rocketman768/ChibiAmp/README.md

# ChibiAmp

A complete 10W amp for the HF bands.

## Copyright and License

Everything in this project is either open-source hardware or open-source
software. Please see the `COPYRIGHT` file for details.
