rocketman768/ChibiAmp/renderings/v1.0-back.png

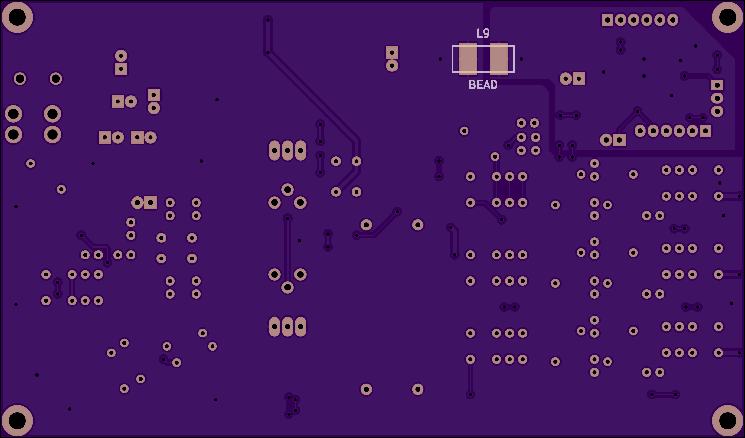
renderings/v1.0-back.png
