rocketman768/ChibiAmp/renderings/v1.0-front.png

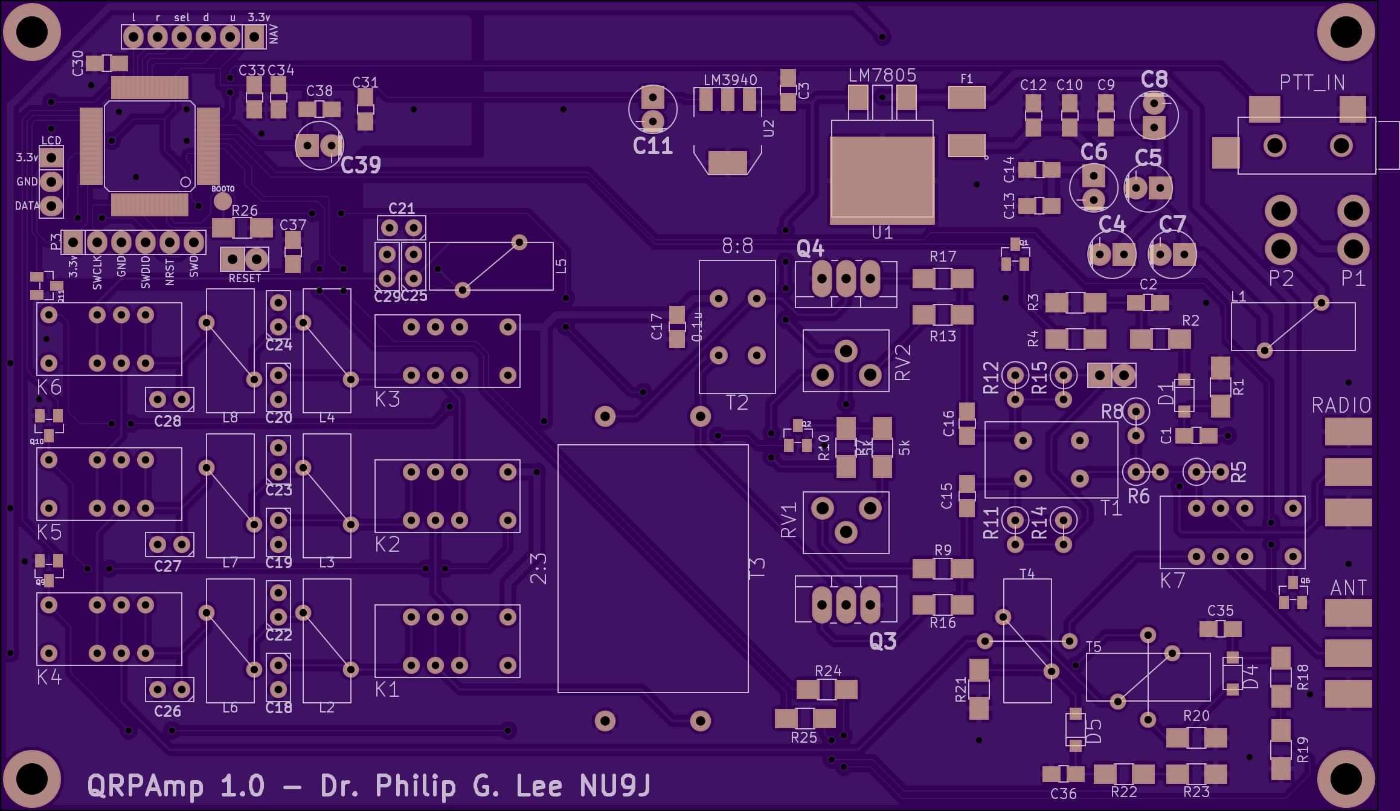
renderings/v1.0-front.png
