rocketman768/ChibiAmp/renderings/v1.1-back.png

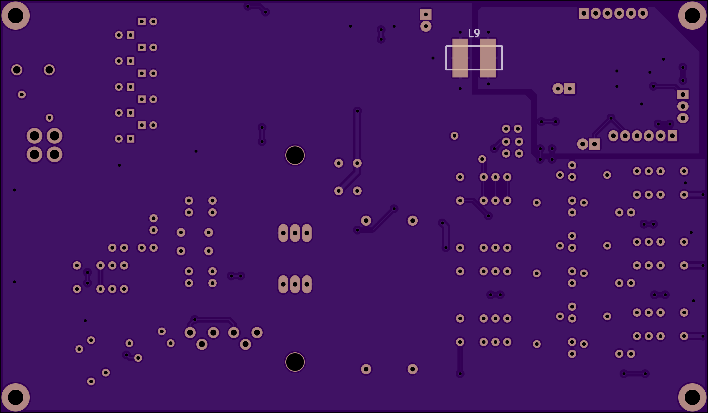
renderings/v1.1-back.png
