rocketman768/ChibiAmp/renderings/v1.1-front.png

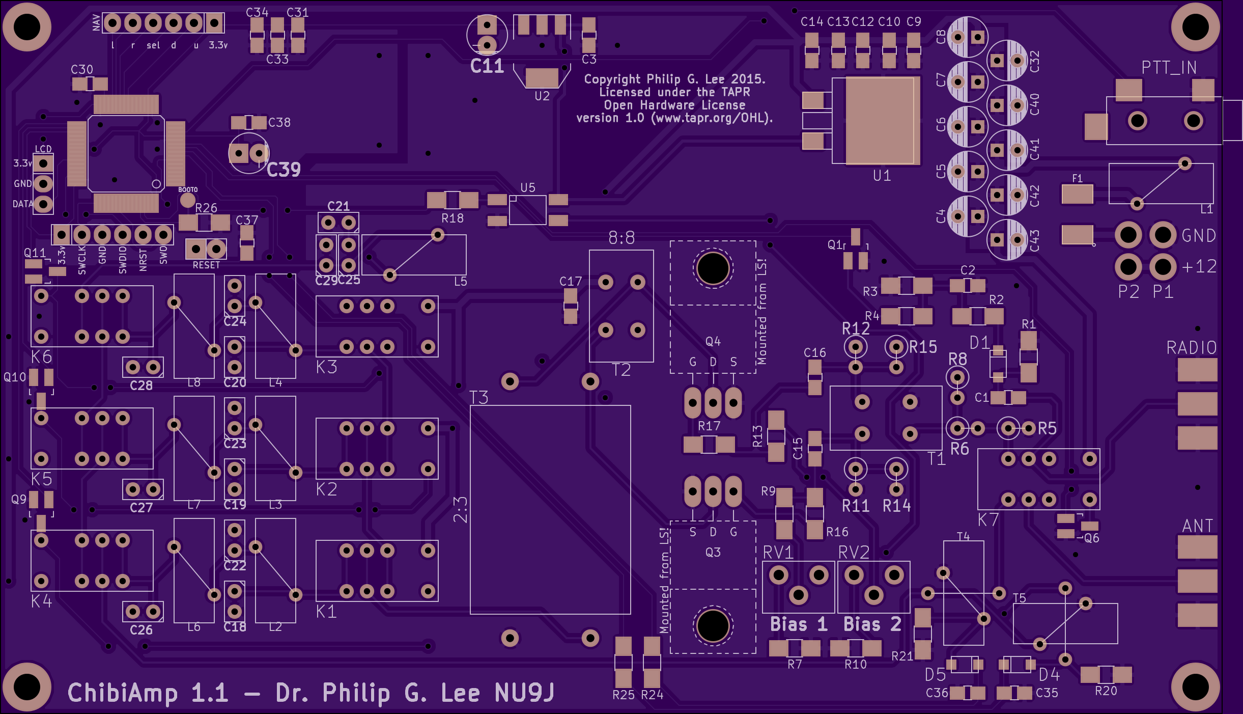
renderings/v1.1-front.png
