rocketman768/ChibiAmp/(threads)

Thread 2 (2015-02-14):

Q1 pads dont match datasheet

rocketman768, 2015-02-14:
Fix by creating EBC symbol and footprint

Closed 2015-03-08.

Thread 6 (2015-03-08):

SWR Measurement Scaling is Wrong

rocketman768, 2015-03-08:
The forward/reflected power scaling is wrong. The way the circuit works, the detected voltage is 1/Nth the real voltage where N is the turns ratio (currently 12). At 20W, the forward line voltage would be 32 V, and the sensed voltage would be 2.6V, well below the 3.3V maximum for the STM32F401.

Next revision should just directly connect to the DC capacitors through the 50k resistors without a voltage divider.

Closed 2015-03-08.

Thread 8 (2015-03-08):

Transistor Placement to Match Heatsink

rocketman768, 2015-03-08:
The transistors should be placed so that the mounting holes line up with the space between the fins.

Closed 2015-07-04.

Thread 10 (2015-03-22):

Resettable fuse trips too early

rocketman768, 2015-03-22:
When the current is 2A, it trips in roughtly 5-10 seconds. At 2A, it should never trip. The designed output power is 10W with about 40% efficiency, i.e. 25W total. This means the total amperage should be 25W / 13.4V = 1.86A. Giving a little headroom, we should expect 2A in normal operation.

PTS18128V200 has a hold current of 2.0A and might be a suitable replacement. However, it has a Vmax of 8V instead of 12V. I think that's OK, since the [spec sheet](http://www.mouser.com/ds/2/87/Bus_Elx_DS_4398_PTS1812_Series-479709.pdf) says this is the maximum voltage at the rated current (100A, which we will definitely never hit).

Closed 2015-07-03.

Thread 9 (2015-03-22):

Gate bias broken

rocketman768, 2015-03-22:
Major issue.

If Q2 has no power applied, then the gate bias to the power MOSFETs is 5V, resulting in about 2A of current. This is enough to trip fuse F1 after 5-10 seconds. This means in the current implementation, Q2 should always be turned on, and power should be flowing.

rocketman768, 2015-03-22:
Might fix this by removing Q2 and placing an optocoupler between +5V and the pots. Mouser part [859-LTV-356T](http://www.mouser.com/ProductDetail/Lite-On/LTV-356T/?qs=sGAEpiMZZMteimceiIVCB4LDcV%252bVgRO4xo2MBcFfZPI%3d) might be suitable.

Closed 2015-07-03.

Thread 11 (2015-12-13):

Extend diode footprints

rocketman768, 2015-12-13:
SD101 footprints are too short

Thread 12 (2015-12-13):

Replace 5k resistors with 4.7k

rocketman768, 2015-12-13:
Maybe some other values with different magnitudes.
