rocketman768/ChibiAmp/qrpamp.kicad_pcb

## KiCad design qrpamp.kicad_pcb (2015-07-06)

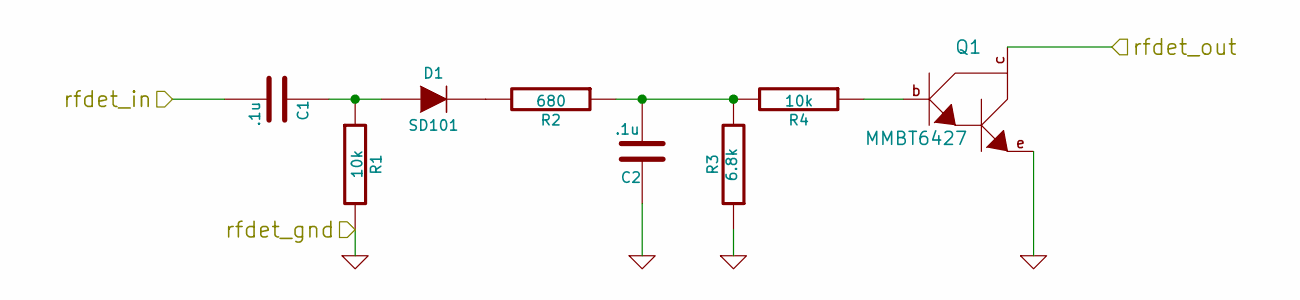
[picture p5: schematic rfdet.sch, ChibiOS 10W HF Amp]

Parts:
C1, C2: .1u; C_0805_HandSoldering
D1: SD101; SOD-123
Q1: MMBT6427; SOT-23-EBC_HandSoldering
R1, R4: 10k; R_1206_HandSoldering
R2: 680; R_1206_HandSoldering
R3: 6.8k; R_1206_HandSoldering

Connections:
/Microcontroller/mcu_rfdet: Q1.c; also elsewhere on the board
/RF In/Out/raw_input: C1.2; also elsewhere on the board
GND: C2.1, Q1.e, R1.2, R3.1; also elsewhere on the board
unnamed: C1.1, D1.1 (A), R1.1
unnamed: C2.2, R2.1, R3.2, R4.2
unnamed: D1.2 (K), R2.2
unnamed: Q1.b, R4.1

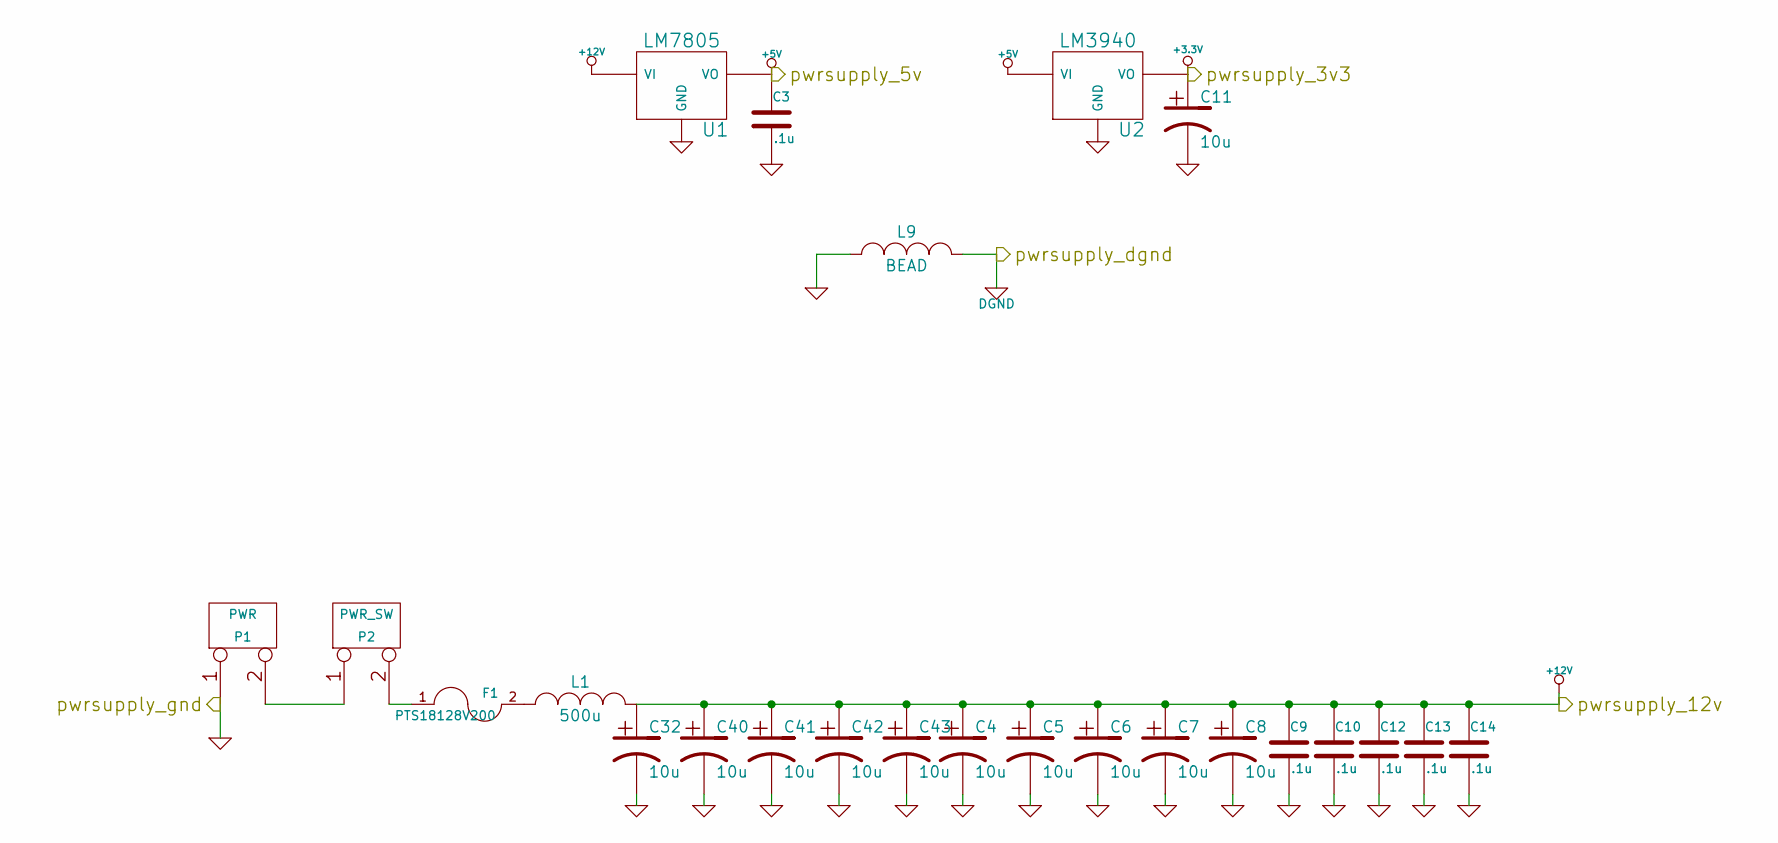
[picture p6: schematic powersupply.sch, ChibiOS 10W HF Amp]

Parts:
C3, C9, C10, C12, C13, C14: .1u; C_0805_HandSoldering
C4, C5, C6, C7, C8, C32, C40, C41, C42, C43: 10u; C_Radial_D5_L11_P2.5
C11: 10u; Capacitor5x11RM2.5
F1: PTS18128V200; SMD-1812_l
L1: 500u; TOROID-50
L9: BEAD; WE-SUCKW
P1: PWR; PWR2-16AWG
P2: PWR_SW; PWR2-16AWG
U1: LM7805; DPAK-3_VIVOGND
U2: LM3940; SOT-223

Connections:
+3.3V: C11.1, U2.VO; also elsewhere on the board
+5V: C3.1, U1.VO, U2.VI; also elsewhere on the board
+12V: C4.1, C5.1, C6.1, C7.1, C8.1, C9.1, C10.1, C12.1, C13.1, C14.1, C32.1, C40.1, C41.1, C42.1, C43.1, L1.2, U1.VI; also elsewhere on the board
DGND: L9.2; also elsewhere on the board
GND: C3.2, C4.2, C5.2, C6.2, C7.2, C8.2, C9.2, C10.2, C11.2, C12.2, C13.2, C14.2, C32.2, C40.2, C41.2, C42.2, C43.2, L9.1, P1.1, U1.GND, U2.GND; also elsewhere on the board
unnamed: F1.1, P2.2 (PM)
unnamed: F1.2, L1.1
unnamed: P1.2 (PM), P2.1

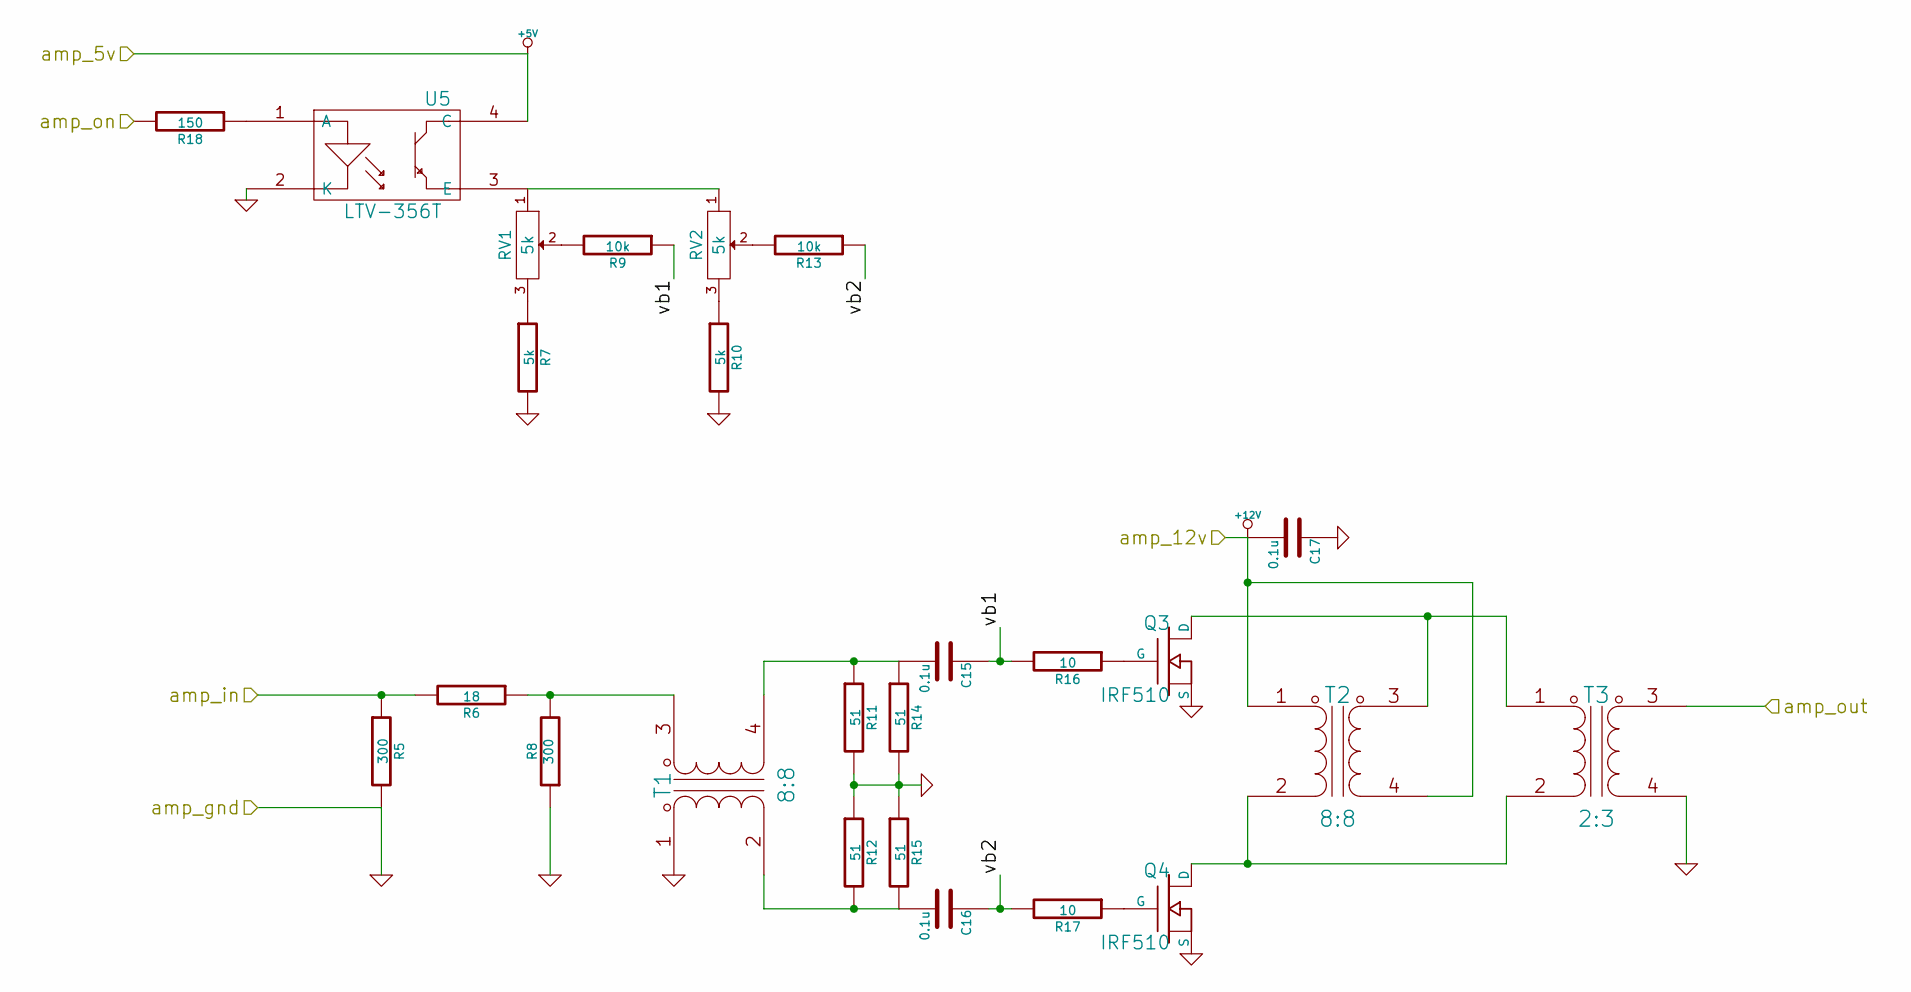
[picture p7: schematic amp.sch, ChibiOS 10W HF Amp]

Parts:
C15, C16, C17: 0.1u; C_0805_HandSoldering
Q3, Q4: IRF510; TO-220_FET-GDS_Horizontal_MountedFromLS_LargePads
R5, R8: 300; R1
R6: 18; R1
R7, R10: 5k; R_1206_HandSoldering
R9, R13: 10k; R_1206_HandSoldering
R11, R12, R14, R15: 51; R1
R16, R17: 10; R_1206_HandSoldering
R18: 150; R_1206_HandSoldering
RV1, RV2: 5k; Potentiometer_Trimmer_Piher_PT10_H01
T1, T2: 8:8; BN2-202
T3: 2:3; BN2-3312
U5: LTV-356T; Optocoupler_SMD_HandSoldering_KPC357_LTV35x_PC357_SingleCha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

Connections:
+5V: U5.4 (C); also elsewhere on the board
+12V: C17.2, T2.1 (PA), T2.4 (SB); also elsewhere on the board
/Amplifier/amp_in: R5.1, R6.2; also elsewhere on the board
/Amplifier/amp_on: R18.2; also elsewhere on the board
/Amplifier/amp_out: T3.3 (SA); also elsewhere on the board
/Amplifier/vb1: C15.1, R9.1, R16.2
/Amplifier/vb2: C16.1, R13.1, R17.2
GND: C17.1, Q3.S, Q4.S, R5.2, R7.2, R8.1, R10.2, R11.2, R12.1, R14.2, R15.1, T1.1 (PA), T3.4 (SB), U5.2 (K); also elsewhere on the board
unnamed: C15.2, R11.1, R14.1, T1.4 (SB)
unnamed: C16.2, R12.2, R15.2, T1.2 (PB)
unnamed: Q3.D, T2.3 (SA), T3.1 (PA)
unnamed: Q3.G, R16.1
unnamed: Q4.D, T2.2 (PB), T3.2 (PB)
unnamed: Q4.G, R17.1
unnamed: R6.1, R8.2, T1.3 (SA)
unnamed: R7.1, RV1.3
unnamed: R9.2, RV1.2
unnamed: R10.1, RV2.3
unnamed: R13.2, RV2.2
unnamed: R18.1, U5.1 (A)
unnamed: RV1.1, RV2.1, U5.3 (E)

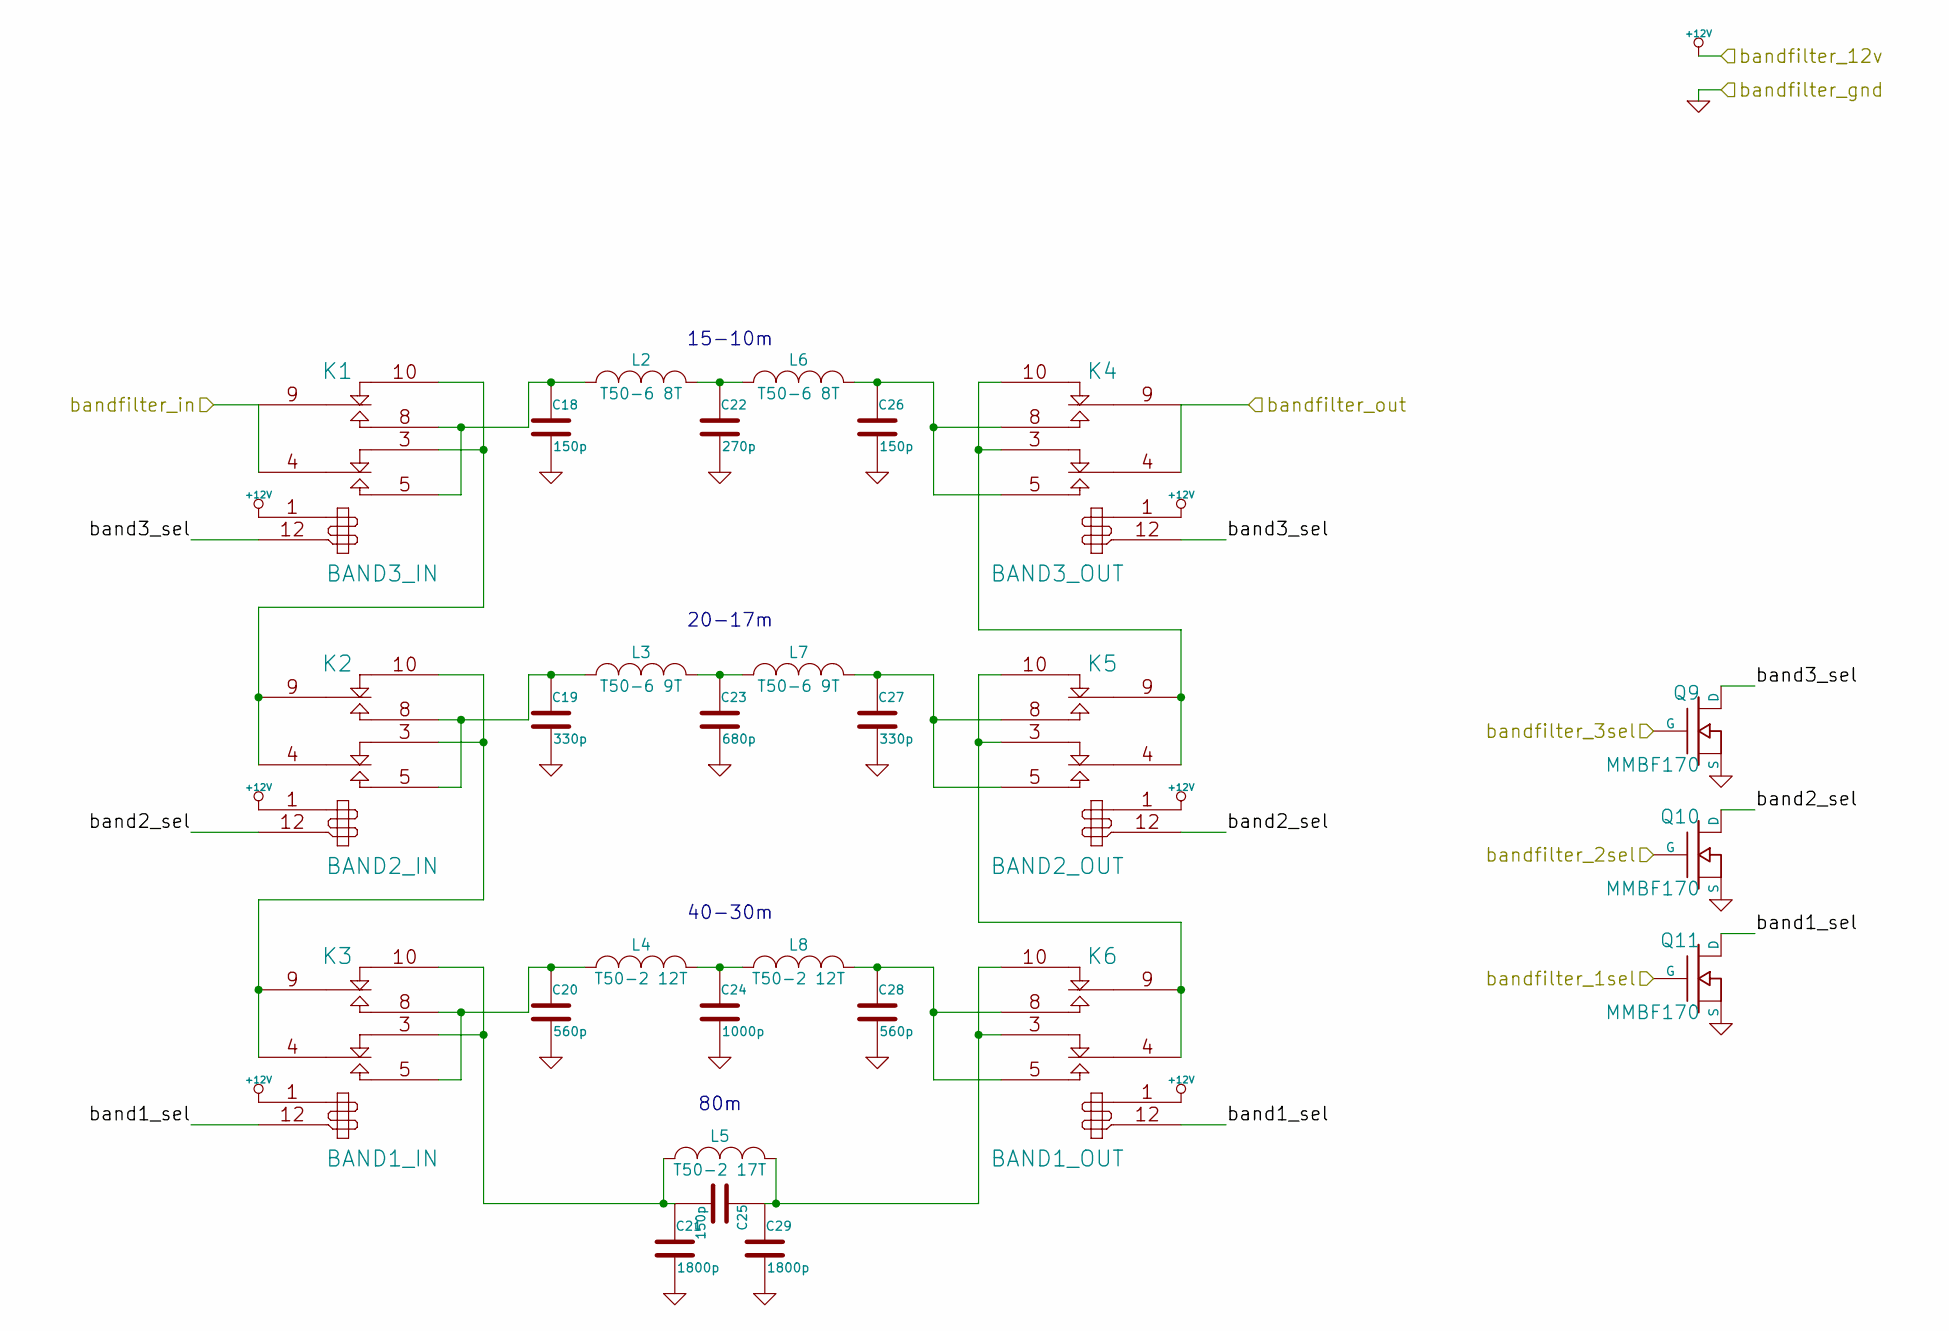
[picture p8: schematic bandfilters.sch, ChibiOS 10W HF Amp]

Parts:
C18, C25, C26: 150p; C1
C19, C27: 330p; C1
C20, C28: 560p; C1
C21, C29: 1800p; C1
C22: 270p; C1
C23: 680p; C1
C24: 1000p; C1
K1: BAND3_IN; EC2-12NU
K2: BAND2_IN; EC2-12NU
K3: BAND1_IN; EC2-12NU
K4: BAND3_OUT; EC2-12NU
K5: BAND2_OUT; EC2-12NU
K6: BAND1_OUT; EC2-12NU
L2, L6: T50-6 8T; TOROID-50
L3, L7: T50-6 9T; TOROID-50
L4, L8: T50-2 12T; TOROID-50
L5: T50-2 17T; TOROID-50
Q9, Q10, Q11: MMBF170; SOT-23-DGS_HandSoldering

Connections:
+12V: K1.1, K2.1, K3.1, K4.1, K5.1, K6.1; also elsewhere on the board
/Amplifier/amp_out: K1.4, K1.9; also elsewhere on the board
/Band Filters/band1_sel: K3.12, K6.12, Q11.D
/Band Filters/band2_sel: K2.12, K5.12, Q10.D
/Band Filters/band3_sel: K1.12, K4.12, Q9.D
/Band Filters/bandfilter_1sel: Q11.G; also elsewhere on the board
/Band Filters/bandfilter_2sel: Q10.G; also elsewhere on the board
/Band Filters/bandfilter_3sel: Q9.G; also elsewhere on the board
/Band Filters/bandfilter_out: K4.4, K4.9; also elsewhere on the board
GND: C18.2, C19.2, C20.2, C21.2, C22.2, C23.2, C24.2, C26.2, C27.2, C28.2, C29.2, Q9.S, Q10.S, Q11.S; also elsewhere on the board
unnamed: C18.1, K1.5, K1.8, L2.1
unnamed: C19.1, K2.5, K2.8, L3.1
unnamed: C20.1, K3.5, K3.8, L4.1
unnamed: C21.1, C25.2, K3.3 (R1), K3.10, L5.1
unnamed: C22.1, L2.2, L6.1
unnamed: C23.1, L3.2, L7.1
unnamed: C24.1, L4.2, L8.1
unnamed: C25.1, C29.1, K6.3 (R1), K6.10, L5.2
unnamed: C26.1, K4.5, K4.8, L6.2
unnamed: C27.1, K5.5, K5.8, L7.2
unnamed: C28.1, K6.5, K6.8, L8.2
unnamed: K1.3 (R1), K1.10, K2.4, K2.9
unnamed: K2.3 (R1), K2.10, K3.4, K3.9
unnamed: K4.3 (R1), K4.10, K5.4, K5.9
unnamed: K5.3 (R1), K5.10, K6.4, K6.9

Notes on the sheet:
80m
40-30m
20-17m
15-10m

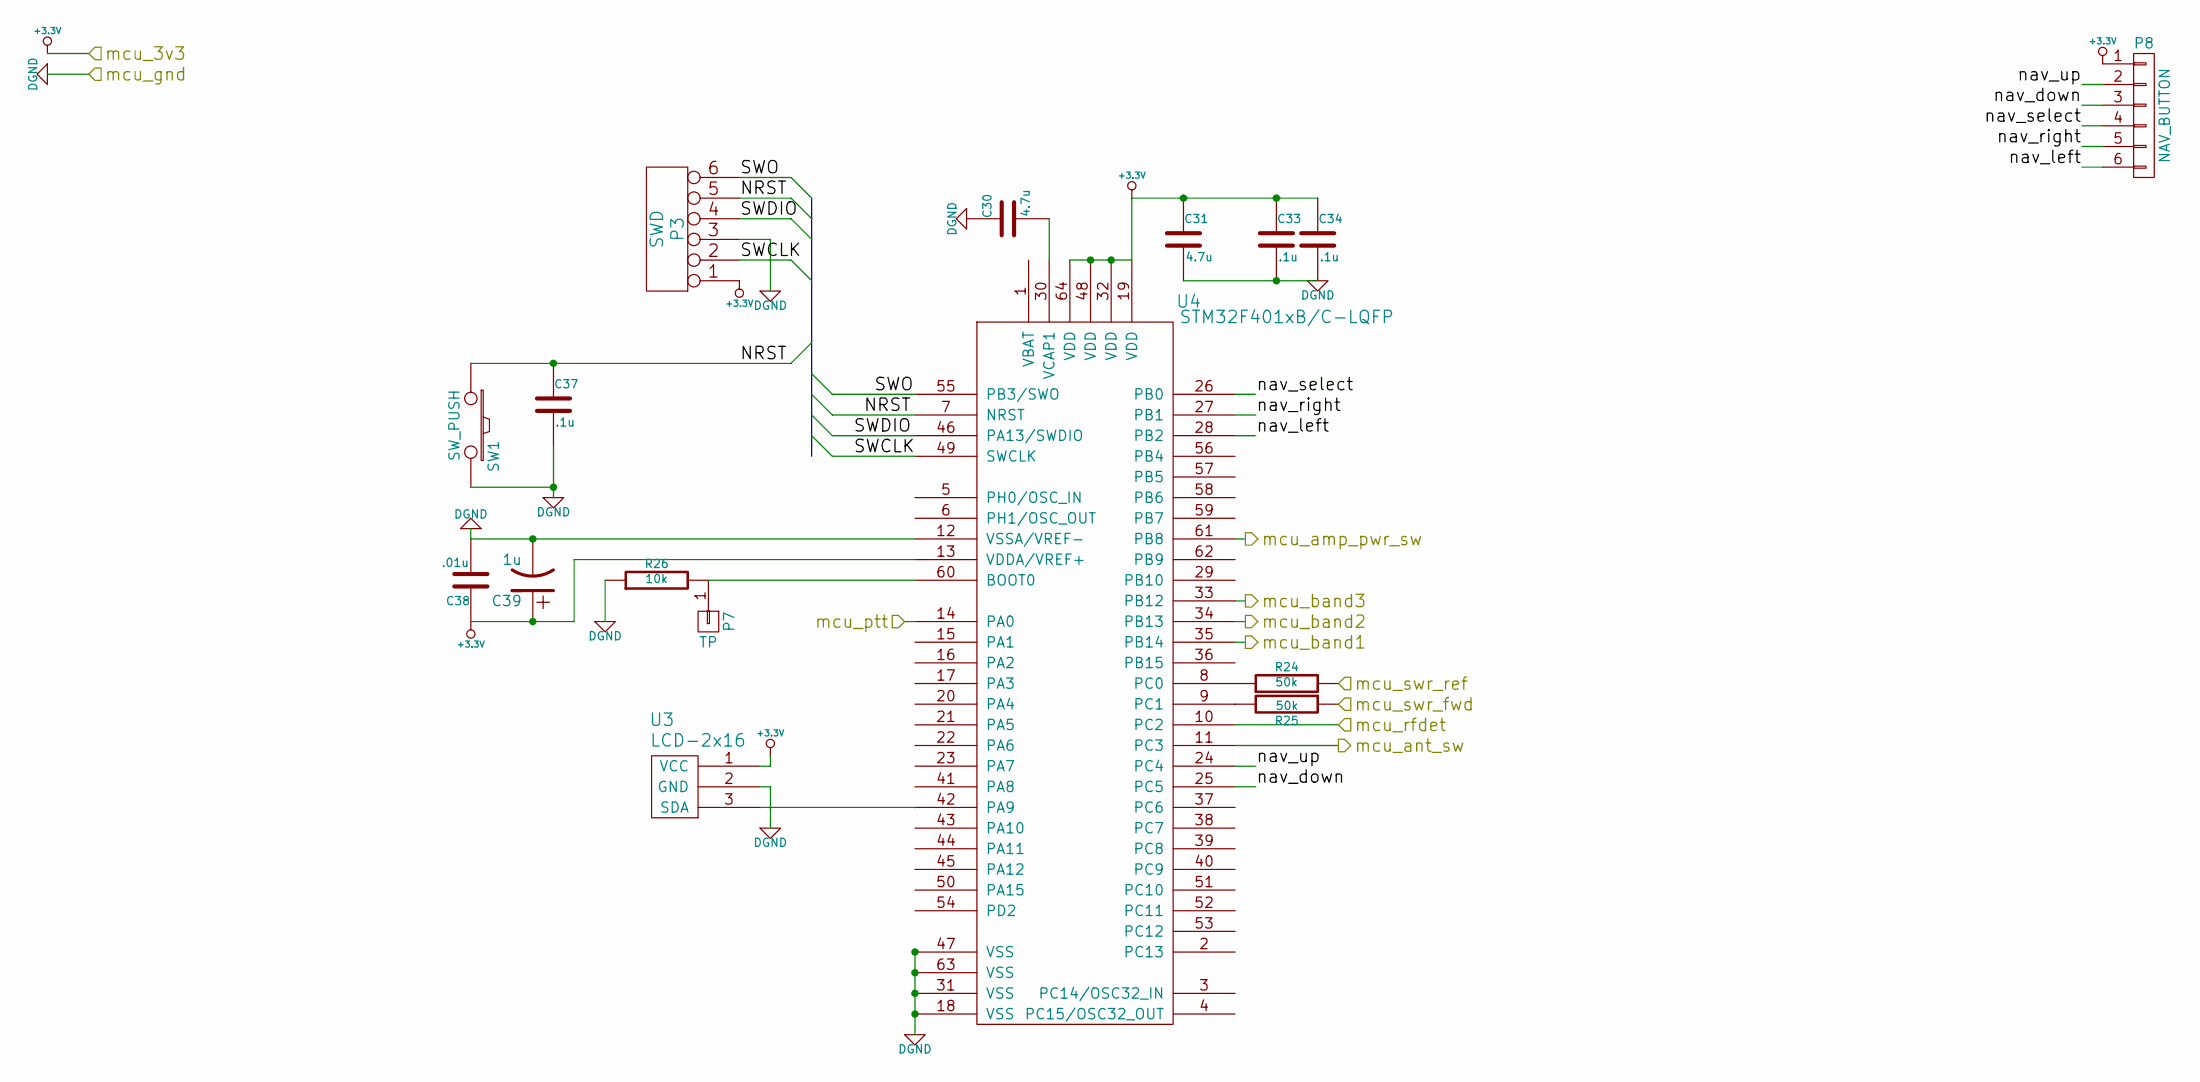
[picture p9: schematic mcu.sch, ChibiOS 10W HF Amp]

Parts:
C30, C31: 4.7u; C_0805_HandSoldering
C33, C34, C37: .1u; C_0805_HandSoldering
C38: .01u; C_0805_HandSoldering
C39: 1u; C_0805_HandSoldering
P3: SWD; Pin_Header_Straight_1x06
P7: TP; Measurement_Point_Round-SMD-Pad_Small
P8: NAV_BUTTON; Pin_Header_Straight_1x06
R24, R25: 50k; R_1206_HandSoldering
R26: 10k; R_1206_HandSoldering
SW1: SW_PUSH; Pin_Header_Straight_1x02
U3: LCD-2x16; Pin_Header_Straight_1x03
U4: STM32F401xB/C-LQFP; LQFP64

Connections:
+3.3V: C31.1, C33.1, C34.1, C38.1, C39.1, P3.1, P8.1, U3.1 (VCC), U4.13 (VDDA/VREF+), U4.19 (VDD), U4.32 (VDD), U4.48 (VDD), U4.64 (VDD); also elsewhere on the board
/Amplifier/amp_on: U4.61 (PB8); also elsewhere on the board
/Band Filters/bandfilter_1sel: U4.35 (PB14); also elsewhere on the board
/Band Filters/bandfilter_2sel: U4.34 (PB13); also elsewhere on the board
/Band Filters/bandfilter_3sel: U4.33 (PB12); also elsewhere on the board
/Microcontroller/NRST: C37.1, P3.5, SW1.1, U4.7 (NRST)
/Microcontroller/SWCLK: P3.2, U4.49 (SWCLK)
/Microcontroller/SWDIO: P3.4, U4.46 (PA13/SWDIO)
/Microcontroller/SWO: P3.6, U4.55 (PB3/SWO)
/Microcontroller/mcu_ptt: U4.14 (PA0); also elsewhere on the board
/Microcontroller/mcu_rfdet: U4.10 (PC2); also elsewhere on the board
/Microcontroller/mcu_swr_fwd: R25.1; also elsewhere on the board
/Microcontroller/mcu_swr_ref: R24.2; also elsewhere on the board
/Microcontroller/nav_down: P8.3, U4.25 (PC5)
/Microcontroller/nav_left: P8.6, U4.28 (PB2)
/Microcontroller/nav_right: P8.5, U4.27 (PB1)
/Microcontroller/nav_select: P8.4, U4.26 (PB0)
/Microcontroller/nav_up: P8.2, U4.24 (PC4)
/RF In/Out/ant_sw_rly: U4.11 (PC3); also elsewhere on the board
DGND: C30.1, C31.2, C33.2, C34.2, C37.2, C38.2, C39.2, P3.3, R26.1, SW1.2, U3.2 (GND), U4.12 (VSSA/VREF-), U4.18 (VSS), U4.31 (VSS), U4.47 (VSS), U4.63 (VSS); also elsewhere on the board
unnamed: C30.2, U4.30 (VCAP1)
unnamed: P7.1, R26.2, U4.60 (BOOT0)
unnamed: R24.1, U4.8 (PC0)
unnamed: R25.2, U4.9 (PC1)
unnamed: U3.3 (SDA), U4.42 (PA9)

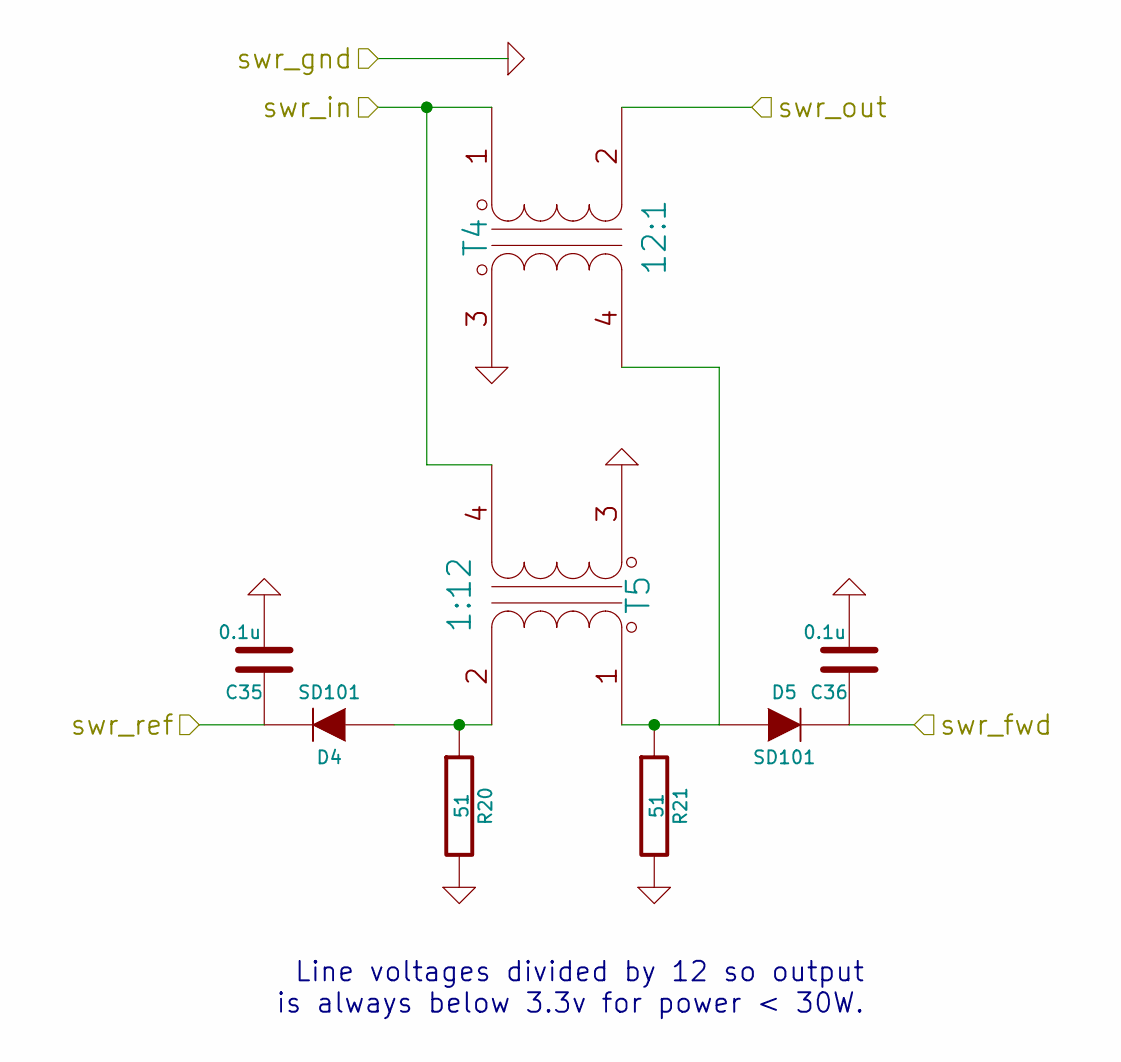
[picture p10: schematic swr.sch, ChibiOS 10W HF Amp]

Parts:
C35, C36: 0.1u; C_0805_HandSoldering
D4, D5: SD101; SOD-123
R20, R21: 51; R_1206_HandSoldering
T4: 12:1; TOROID2-50-singleturn
T5: 1:12; TOROID2-50-singleturn

Connections:
/Band Filters/bandfilter_out: T4.1 (PA), T5.4 (SB); also elsewhere on the board
/Microcontroller/mcu_swr_fwd: C36.1, D5.2 (K); also elsewhere on the board
/Microcontroller/mcu_swr_ref: C35.1, D4.2 (K); also elsewhere on the board
/RF In/Out/from_final: T4.2 (PB); also elsewhere on the board
GND: C35.2, C36.2, R20.2, R21.2, T4.3 (SA), T5.3 (SA); also elsewhere on the board
unnamed: D4.1 (A), R20.1, T5.2 (PB)
unnamed: D5.1 (A), R21.1, T4.4 (SB), T5.1 (PA)

Notes on the sheet:
Line voltages divided by 12 so output is always below 3.3v for power < 30W.

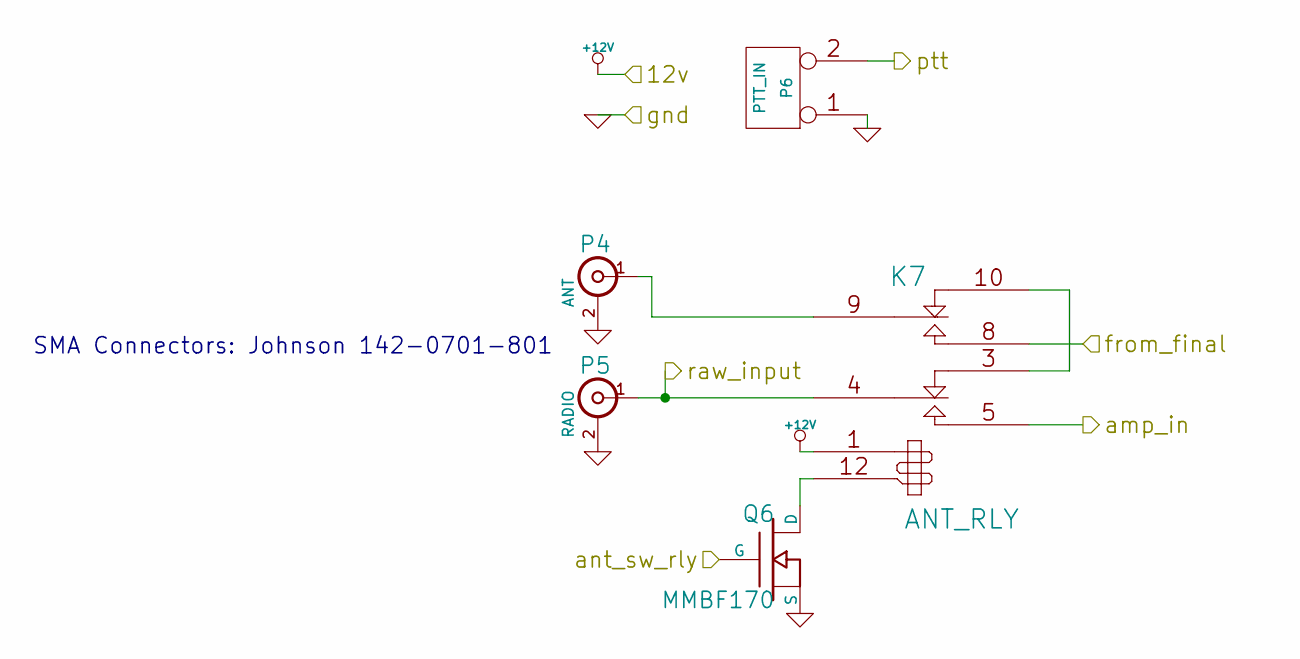
[picture p11: schematic rfinout.sch, ChibiOS 10W HF Amp]

Parts:
K7: ANT_RLY; EC2-12NU
P4: ANT; SMA-EDGE-0.375in
P5: RADIO; SMA-EDGE-0.375in
P6: PTT_IN; 3.5MM_SWITCHCRAFT-35RASMT2AHNTRX
Q6: MMBF170; SOT-23-DGS_HandSoldering

Connections:
+12V: K7.1; also elsewhere on the board
/Amplifier/amp_in: K7.5; also elsewhere on the board
/Microcontroller/mcu_ptt: P6.2 (PM); also elsewhere on the board
/RF In/Out/ant_sw_rly: Q6.G; also elsewhere on the board
/RF In/Out/from_final: K7.8; also elsewhere on the board
/RF In/Out/raw_input: K7.4, P5.1 (In); also elsewhere on the board
GND: P4.2 (Ext), P5.2 (Ext), P6.1, Q6.S; also elsewhere on the board
unnamed: K7.9, P4.1 (In)
unnamed: K7.3 (R1), K7.10
unnamed: K7.12, Q6.D

Notes on the sheet:
SMA Connectors: Johnson 142-0701-801

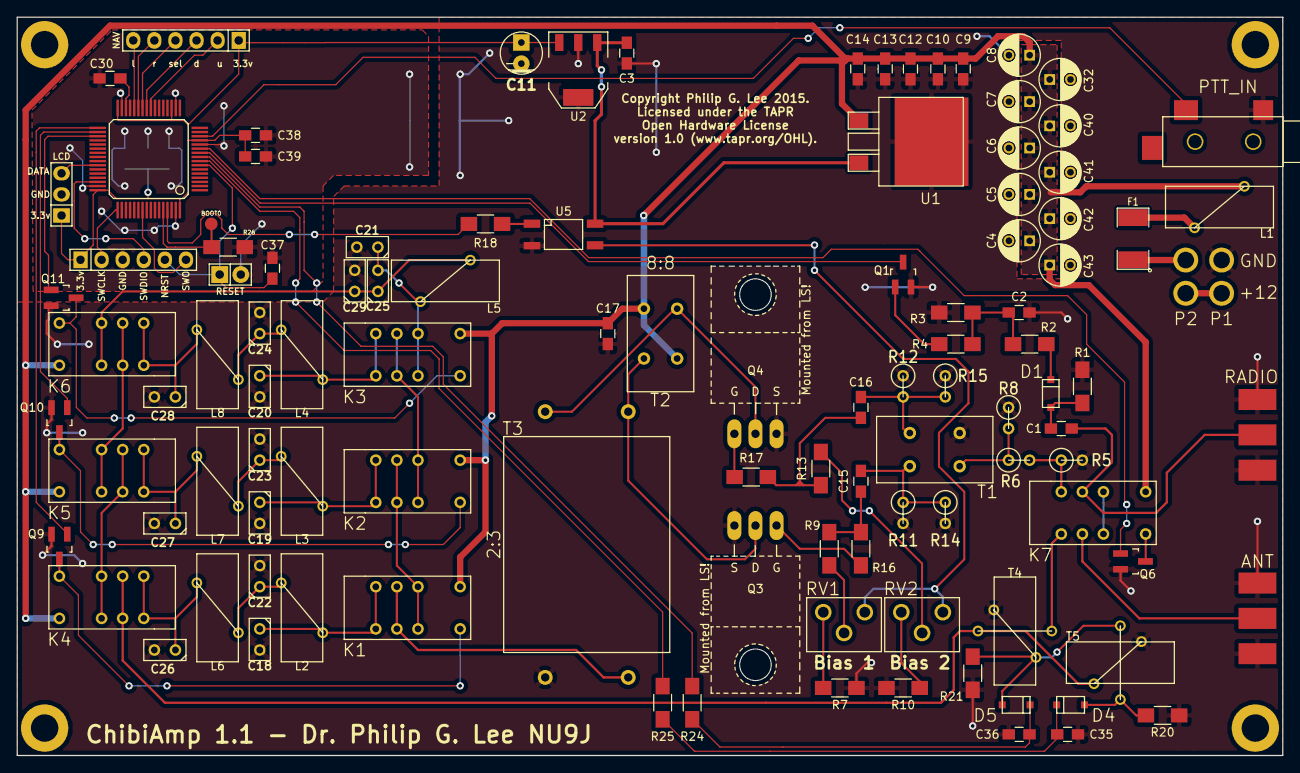
[picture p12: board qrpamp.kicad_pcb from above]

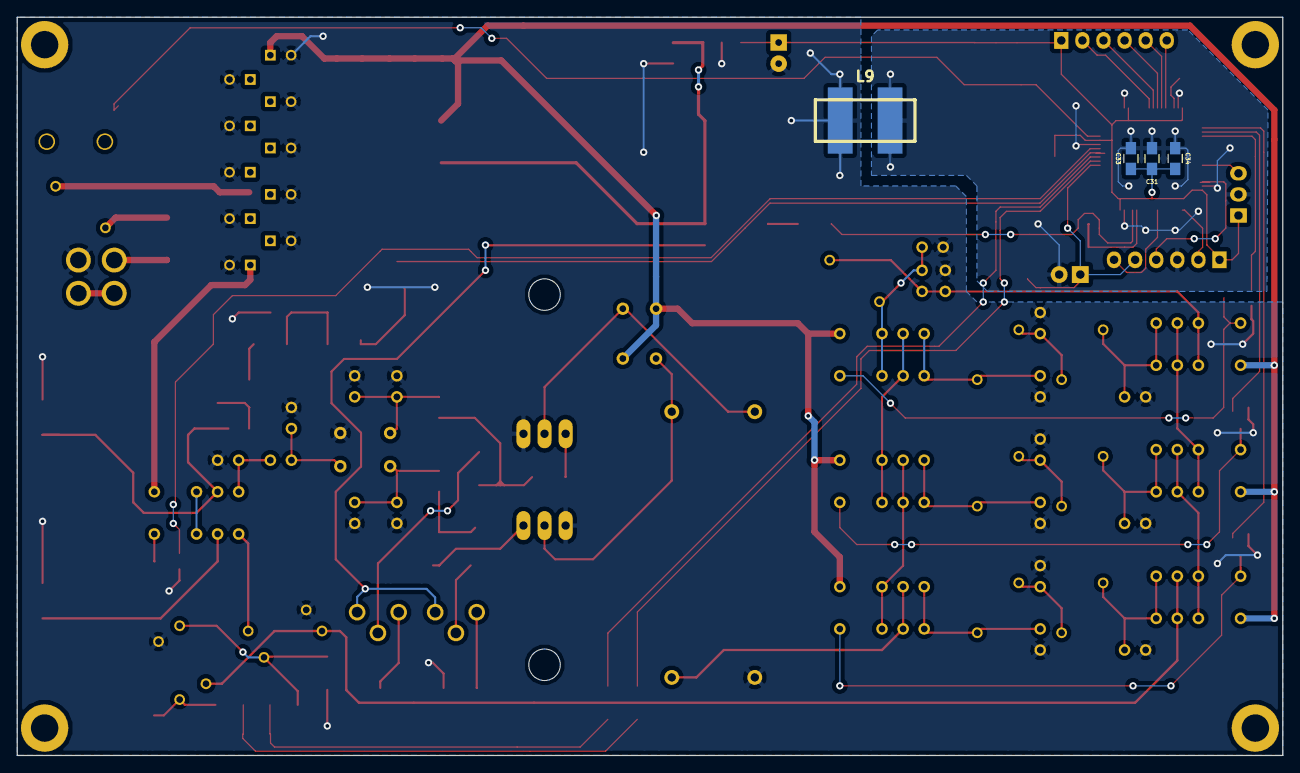
[picture p13: board qrpamp.kicad_pcb from below]

Board: 2 copper layers, 152.4 x 88.9 mm, 118 parts (4 on the bottom side), 78 nets.

Other parts of the board:
Mounting Hole: VAL**; MountingHole4-40
Mounting Hole#2, Mounting Hole#3, Mounting Hole#4: VAL**; MountingHole4-40
