rocketman768/ChibiAmp/(commit log)

2014-11-27 Initial commit. Mostly-complete schematics.
    [amp.sch, bandfilters.sch, mcu.sch, powersupply.sch, qrpamp.sch, rfdet.sch, rfinout.sch, swr.sch]
2014-11-27 Finished/annotated rfdet schematic
    [amp.sch, bandfilters.sch, mcu.sch, powersupply.sch, qrpamp.sch, rfdet.sch, rfinout.sch, swr.sch]
2014-11-28 Added simulation dir
    Also, due to simulation, modified the rf detector circuit
    to have higher input impdedance to distort the input rf
    less.
    [rfdet.sch]
2014-11-28 Annotated all schematics
    - Added more caps to power supply
    - Decided on power supply fuse part
    - Changed 1n5711 SWR caps to BAT62
    - Decided on MMBF170 for amp bias switch
    [amp.sch, bandfilters.sch, mcu.sch, powersupply.sch, qrpamp.sch, rfdet.sch, rfinout.sch, swr.sch]
2014-11-28 Added component footprint file
2014-11-28 Associated SMD resistors with 1206 footprint
2014-11-28 Pull in nu9j-footprints for LQFP64 package
2014-11-29 Associate more footprints
    - Removed flyback diodes from amp
    - Changed BAT62 -> SD101 (BAT62 is EOL)
    - Changed R and C footprints for hand-soldered versions
    - Associated through-hole cap footprints
    - Associated regulator footprints
    [amp.sch, bandfilters.sch, mcu.sch, powersupply.sch, qrpamp.sch, rfdet.sch, rfinout.sch, swr.sch]
2014-11-29 Associated transistor footprints
2014-11-29 Associated through-hole resistor footprints
2014-11-29 Finished band filters schematic
    - Associated last of the capacitors with footprints
    - Associated inductors
    [amp.sch, bandfilters.sch, mcu.sch, powersupply.sch, qrpamp.sch, rfdet.sch, rfinout.sch, swr.sch]
2014-11-30 Finished associating relays
    [amp.sch, bandfilters.sch, mcu.sch, powersupply.sch, qrpamp.sch, rfdet.sch, rfinout.sch, swr.sch]
2014-11-30 Associated ANT_RLY with footprint
2014-12-06 Everything associated except joystick
    [amp.sch, bandfilters.sch, mcu.sch, powersupply.sch, qrpamp.sch, rfdet.sch, rfinout.sch, swr.sch]
2014-12-06 Joystick is now 5-pin header and associated
    Now we are ready to lay out the board!
    [mcu.sch, rfinout.sch, swr.sch]
2014-12-06 Generated BOM
    [qrpamp.csv]
2014-12-06 Note about SMA connector part number
    [rfinout.sch]
2014-12-06 Added pcb
    [qrpamp.kicad_pcb]
2014-12-07 Fixed pin assignment issues in pcb layout
    [amp.sch, powersupply.sch, qrpamp.kicad_pcb, swr.sch]
2014-12-07 Separate analog/digital gnd. Add some filtering caps and reset button.
    [amp.sch, bandfilters.sch, mcu.sch, powersupply.sch, qrpamp.kicad_pcb, qrpamp.sch, rfdet.sch, rfinout.sch]
2014-12-08 All layed out
    Several net errors fixed, and some mcu pins reassigned for better layout.
    [amp.sch, bandfilters.sch, mcu.sch, qrpamp.kicad_pcb, rfinout.sch, swr.sch]
2014-12-13 Connected all mcu VSS and VDD pins.
    [bandfilters.sch, mcu.sch, qrpamp.kicad_pcb, rfinout.sch]
2014-12-13 Updated nu9j-libraries for new STM401 changes
    [mcu.sch]
2014-12-13 Added ADC input resistors
    Also reassigned the band switch pins on the 401 for better layout.
    [mcu.sch, qrpamp.kicad_pcb]
2015-01-25 Fixed issues found with test board
    - Added MOSFETs to relay switch lines from MCU
    - Reconnected SWR in/out to actual ADC pins
    - Changed LM3940 footprint to SOT223
    - Added 4th mounting hole
    - Swapped joystick for nav button
    - Extended pads of STM32F401 for easier soldering
    [bandfilters.sch, mcu.sch, qrpamp.kicad_pcb, qrpamp.sch, rfinout.sch, swr.sch]
2015-01-25 Off to the fab!
    Had to fix an issue where the GND-DGND bead was not putting solder
    mask on the bottom pads.
    [qrpamp.GBL, qrpamp.GBO, qrpamp.GBS, qrpamp.GKO, qrpamp.GTL, qrpamp.GTO, qrpamp.GTS, qrpamp.XLN]
2015-02-04 Remade BOM
    [qrpamp.csv]
2015-03-08 Put TAPR copyright notice on silkscreen
    This fixes #1. Also, change "QRPAmp" to "ChibiAmp" on front silkscreen.
    [qrpamp.kicad_pcb]
2015-03-08 Fixes #5: bad bias pot pin numbers
    [qrpamp.kicad_pcb]
2015-03-08 Fixes #6: removes SWR measurement voltage divider
    [powersupply.sch, qrpamp.kicad_pcb, swr.sch]
2015-03-08 Fixes #2: Q1 pads did not match
    [amp.sch, bandfilters.sch, mcu.sch, powersupply.sch, qrpamp.sch, rfdet.sch, rfinout.sch, swr.sch]
2015-03-08 Closes #3: extend SOT23 pads
    [qrpamp.kicad_pcb]
2015-03-08 Fixes #7: board to 6x3.5 inches
    Have not yet moved all the parts around.
    [qrpamp.kicad_pcb]
2015-03-08 Closes #4: extend chassis pads
    [qrpamp.kicad_pcb]
2015-03-08 Schematic changes to go with #3 (extending sot23 pads)
    [amp.sch, bandfilters.sch, rfdet.sch, rfinout.sch]
2015-07-03 Fixes #9: gate bias broken
    Replaces Q2 with LTV-356T opto-coupler between 5V and bias rail
    [amp.sch, bandfilters.sch, mcu.sch, qrpamp.kicad_pcb, rfinout.sch, swr.sch]
2015-07-03 Fixes #10: resettable fuse trips too easily
    Replaced fuse with PTS18128V200 that has a hold current of 2.0A
    instead of 1.5A.
    [powersupply.sch]
2015-07-04 Fixes #8: transistor placement
    Also, this is a major board layout change
    - Added more 12V filtering caps
    - Placed fuse in front of filtering caps
    - Changed IRF510 footprints to horizontal lower side w/ mounting hole
    - Expanded layout to fill new board size
    [amp.sch, bandfilters.sch, mcu.sch, powersupply.sch, qrpamp.kicad_pcb, rfinout.sch, swr.sch]
2015-07-04 Silkscreen cleanup
    [qrpamp.kicad_pcb]
2015-07-04 Fab - v1.1
    Version 1.1 is off to the fab
    [qrpamp.GBL, qrpamp.GBO, qrpamp.GBS, qrpamp.GKO, qrpamp.GTL, qrpamp.GTO, qrpamp.GTS, qrpamp.XLN]
2015-07-04 Add copyright and license to all schematics
    [amp.sch, bandfilters.sch, mcu.sch, powersupply.sch, qrpamp.sch, rfdet.sch, rfinout.sch, swr.sch]
2015-07-04 Added a few ground vias, cleaned up some dangling tracks
    [qrpamp.kicad_pcb]
2015-07-05 Put MCU decoupling caps on bottom under MCU
    This is per the design recommendations in 'PCB Design Guidelines for
    Reduced EMI' here: http://www.ti.com/lit/an/szza009/szza009.pdf
    [mcu.sch, qrpamp.kicad_pcb]
2015-07-05 Added the OSHPark renderings for the v1.0 and v1.1 boards
2015-07-06 Added gnd vias to fill in ground pours
    [qrpamp.kicad_pcb]
2015-11-30 Update BOM to reflect v1.1 board
    [qrpamp.csv]
2015-11-30 Update project to kicad bzr 6336
    I guess some parts are now outdated
    [amp.sch, bandfilters.sch, mcu.sch, powersupply.sch, qrpamp.sch, rfdet.sch, rfinout.sch, swr.sch]
