rocketman768/ChibiAmp/(notices)

Notices in the files:
swr.sch:
Licensed under the TAPR Open Hardware License
Copyright 2015, Philip G. Lee
qrpamp.kicad_pcb:
Copyright Philip G. Lee 2015.
